itenium-be/BuildYourOwnMacroPad/README.md

Build Your Own MacroPad
=======================

[Hands-On event at itenium](https://itenium.be/blog/dev-setup/build-your-own-macropad)

[Instructions](https://itenium-be.github.io/BuildYourOwnMacroPad/) website.

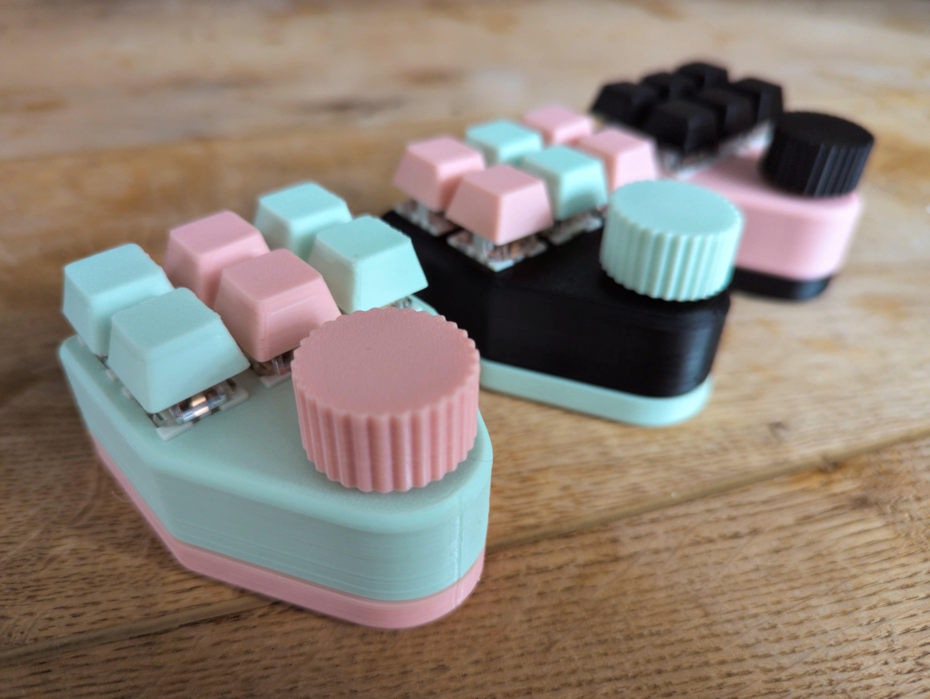
[picture p1: docs/assets/goal.jpg]
The Goal
