itenium-be/BuildYourOwnMacroPad/Macropad.pptx

## Macropad

## Wat gaan we bouwen

- Programmeerbaar mini toetsenbord


## Componenten

- Rotary Encoder
- Keyboard Switches
- Microcontroller

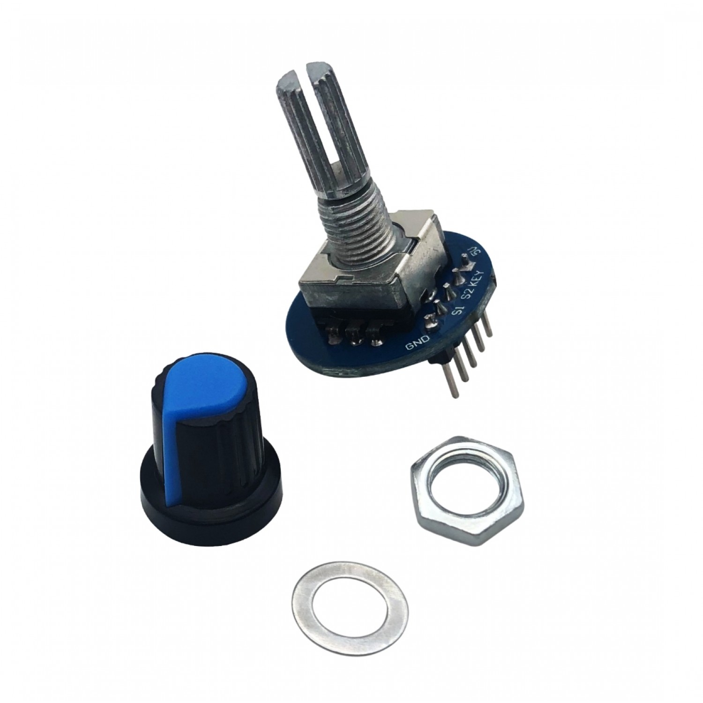
[picture p7: figure]
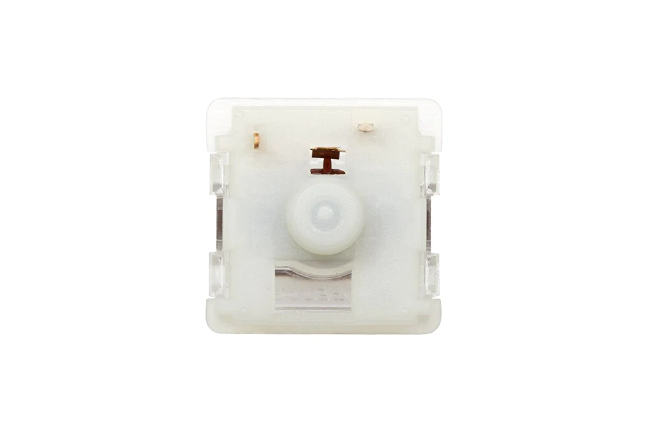
[picture p8: figure]
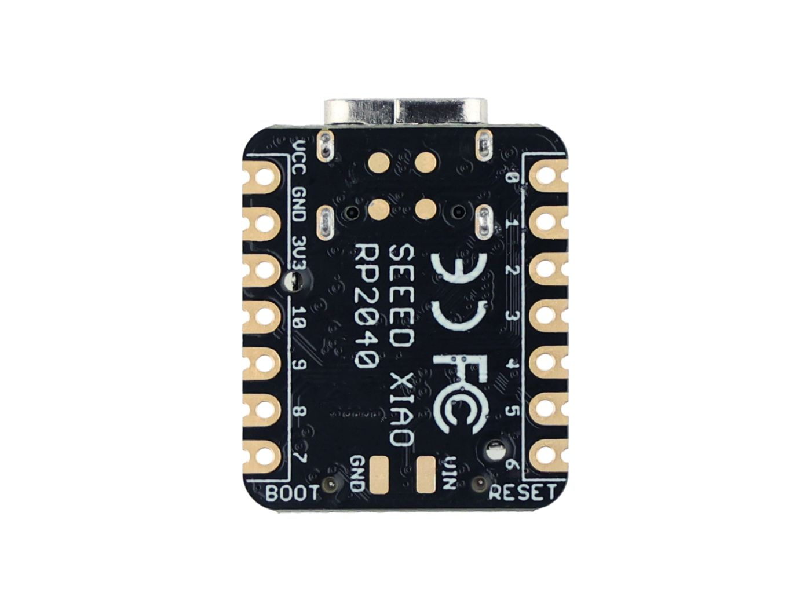
[picture p9: figure]

## Hoe verloopt de sessie?

- Praktische focus
- Iedereen eerst “headers Solderen”
- Elkaar helpen

## Gids

- https:// (https://itenium.be/BuildYourOwnMacroPad/)itenium.be/BuildYourOwnMacroPad/
