itenium-be/BuildYourOwnMacroPad/docs/parts-list.md

# Parts list

## Components

- [1x XIAO RP2040](https://www.tinytronics.nl/shop/en/development-boards/microcontroller-boards/others/seeed-studio-seeeduino-xiao-rp2040-dual-core-cortex-m0-separate-headers)
- [1x Rotary encoder](https://www.tinytronics.nl/shop/en/switches/manual-switches/rotary-encoders/rotary-encoder-module)
- [22x Pin headers](https://www.tinytronics.nl/shop/en/cables-and-connectors/connectors/pin-headers/male/40-pins-header-male)
- [Short](https://www.tinytronics.nl/shop/en/cables-and-connectors/cables-and-adapters/prototyping-wires/dupont-compatible-and-jumper/dupont-jumper-wire-female-female-10cm-10-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) and [long jumper wires](https://www.tinytronics.nl/shop/en/cables-and-connectors/cables-and-adapters/prototyping-wires/dupont-compatible-and-jumper/dupont-jumper-wire-female-female-20cm-10-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)
- [6x Keyboard switches](https://www.alternate.nl/Sharkoon/Gateron-PRO-2-0-BROWN-Switch-Set-keyboard-switches/html/product/1892291)
- [4x M3*8mm machine bolts](https://www.rvspaleis.nl/bouten/binnenzeskant/din-912/din-912-[-]-a2/din-912-[-]-a2-[-]-m3/912-2-3x8_100)

## 3D printed files

- [6x Keycaps](https://www.printables.com/model/118708-simple-cherry-mx-keycap)
- [1x Upper housing](assets/Housing_Upper.stl)
- [1x Lower housing](assets/Housing_Lower.stl)
- [1x Knob](assets/Knob.stl)
