itenium-be/BuildYourOwnMacroPad/docs/assets/Knob.stl

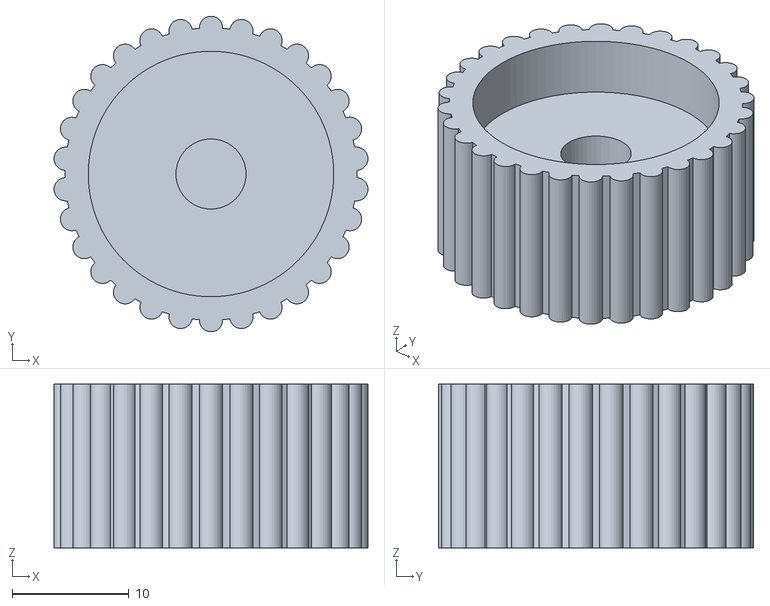
[picture p10: CAD file, 2023-10-06]
docs/assets/Knob.stl
26.9 x 27.0 x 14.0
