itenium-be/BuildYourOwnMacroPad/docs/assets/Housing_Lower.stl

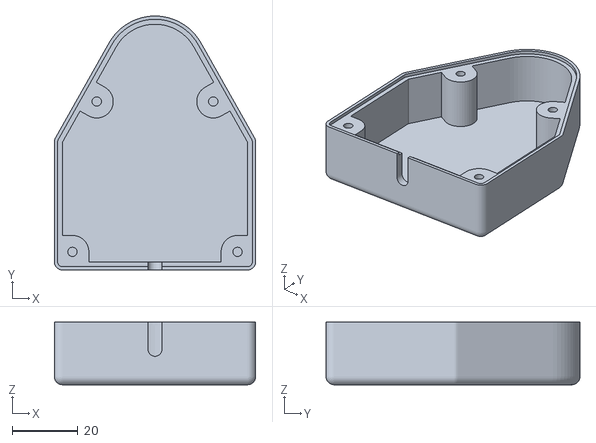
[picture p11: CAD file, 2023-10-06]
docs/assets/Housing_Lower.stl
61.1 x 77.1 x 19.0
