itenium-be/BuildYourOwnMacroPad/docs/assets/Housing_Upper.stl

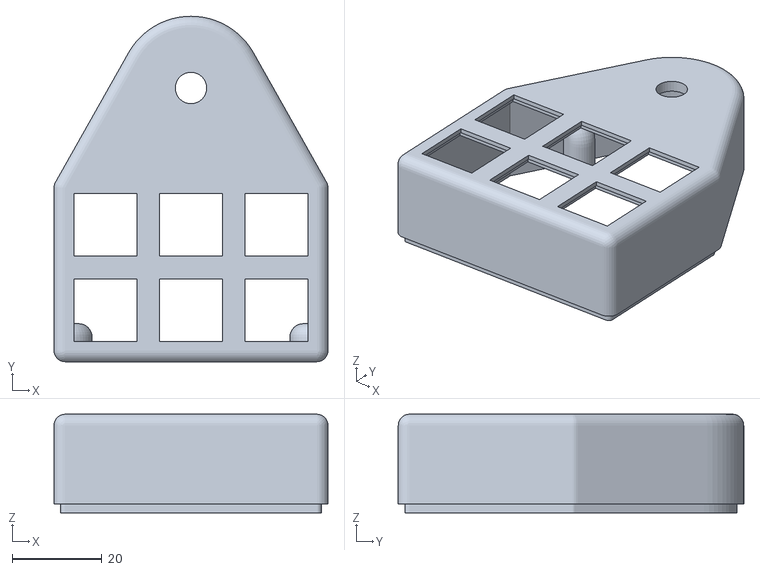
[picture p12: CAD file, 2023-10-06]
docs/assets/Housing_Upper.stl
61.1 x 77.1 x 22.0
