itenium-be/BuildYourOwnMacroPad/docs/solder-headers.md

# Soldering the headers

You'll be divided up into groups, each with their own soldering iron and some basic tools.

We'll need to solder pin headers to our microcontroller, and wires to each of our keyboard switches.

## The microcontroller

In this project we'll be using (a tiny!) microcontroller based on the [RP2040 chip](https://www.raspberrypi.com/documentation/microcontrollers/rp2040.html) by Raspberry Pi. Their default board is a bit big for this project though, so we use a tiny board with the same chip on it. The [XIAO RP2040](https://www.seeedstudio.com/XIAO-RP2040-v1-0-p-5026.html).

To make it a bit easier on ourselves (it'll be hard enough already 😃) we'll start by soldering headers onto our board.

These are tiny pins we can plug things into later.

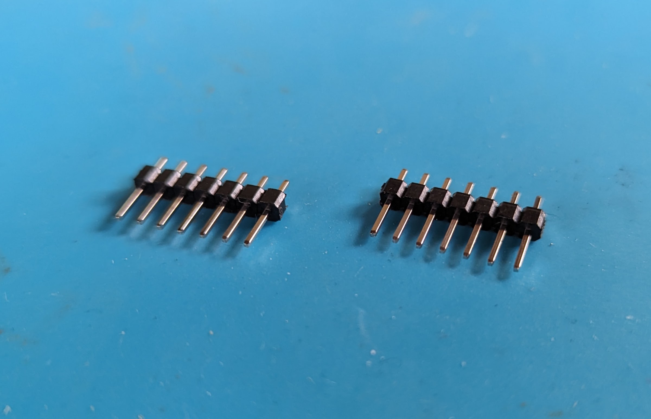
[picture p13: docs/assets/headers.jpg]
Headers


Start by making sure you've got 2 rows of 7 pins. Then we'll fit these onto our board, and then stick this upside down onto a breadboard.

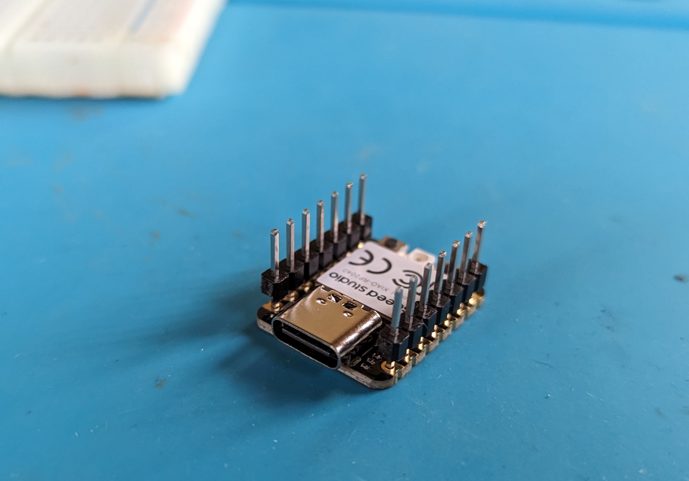
[picture p14: docs/assets/headers-fitted.jpg]
Headers


Headers

Once the board and headers are firmly in their place we'll solder all 14 pins. I'll come by to get everyone started, but make sure to have a look at [this short guide](https://www.makerspaces.com/how-to-solder/).

Headers

Headers

**Next up** installing the [required software](software-setup.md), and making an LED blink!
