itenium-be/BuildYourOwnMacroPad/docs/assembly.md

# Assembly

We've prepared all of our parts, soldered what needed soldering, now it's on to assembly!

## Install keycaps

Choose some keycaps and press them firmly onto the switches.

## Install the knob

The knob should be a tight fit, press it on firmly until it bottoms out.

## Plug in the USB cable

You should know how to do this 😉.

## Close it up

Fit the bottom and top part of your macropad together, making sure there are no wires interfering. Then close the macropad using the 4 M3*8mm screws.

**Next up** [finishing touches](finishing-touches.md).
