itenium-be/BuildYourOwnMacroPad/(commit log)

2023-10-06 Add parts list
    [Housing_Lower.stl, Housing_Upper.stl, Knob.stl]
2023-10-09 Add powerpoint
